PiotrPokornowski/ELA2/README.md

# Projekt na zaliczenie ELA2



W ramach projektu wykonane zostały projekty 4 linii zasilających z wykorzystaniem przetowornic impulsowych i stabilizatorów napięcia.
Symulacje układów zostały przeprowadzone z wykorzystaniem rzeczywistych modeli elementów w LTSpice.
