PiotrPokornowski/ELA2/Projekt/docs/BOM.xlsx

Sheet: Digital
Element | Kod producenta | wartość
C1 | GRM155R61C105KA12 | 1u
C2 | GRM155R61C103KA01 | 10n
C3 | GRM155R61C104KA88 | 0.1u
C4 | 865080543009 | 47u
C5 | GRM1555C1H4R7BA01 | 47p
C6 | GRM188R61C106MA73 | 10u
C7 | GRT31MR61C155KE01 | 1.5u
C8 | GRT31MR61C155KE01 | 1.5u
C9 | GRT31MR61C155KE01 | 1.5u
C10 | 865080543009 | 47u
L1 | 7447706033 | 3.3u
Przetwornica | LT8640

Sheet: Analog 1
Element | Kod producenta | wartość
C1 | GRT31MR61C155KE01 | 1.5u
C2 | GRT155R61A475ME13 | 4.7u
Stabilizator | LT3012

Sheet: Analog 2
Element | Kod producenta | wartość
C1 | GRM155R61C103KA01 | 10n
C2 | GRT31MR61C155KE01 | 1.5u
C3 | GRM155R61C105KA12 | 1u
C4 | GRT1555C1E681JA02 | 680p
C5 | GRM1555C1E4R7CA01 | 4.7p
C6 | GRM188R61C106MA73 | 10u
C7 | GRM188R61C106MA73 | 10u
C8 | GRM188R61C106MA73 | 10u
C9 | GRM188R61C106MA73 | 10u
C10 | GRM188R61C106MA73 | 10u
C11 | GRM188R61C106MA73 | 10u
C12 | GRM188R61C106MA73 | 10u
L1 | 78404064047 | 4.7u
L2 | 78404064047 | 4.7u
L3 | 7447706033 | 3.3u
D1 | DFLS260
Przetwornica | LT8362

Sheet: Analog 3
Element | Kod producenta | wartość
C1 | GRM155R61C103KA01 | 10n
C2 | GRT31MR61C155KE01 | 1.5u
C3 | GRM155R61C105KA12 | 1u
C4 | GRT1555C1E681JA02 | 680p
C5 | GRM1555C1E4R7CA01 | 4.7p
C6 | GRM188R61C106MA73 | 10u
C7 | GRM188R61C106MA73 | 10u
C8 | GRM188R61C106MA73 | 10u
C9 | GRM188R61C106MA73 | 10u
C10 | GRM188R61C106MA73 | 10u
C11 | GRM188R61C106MA73 | 10u
C12 | GRM188R61C106MA73 | 10u
L1 | 78404064047 | 4.7u
L2 | 78404064047 | 4.7u
L3 | 7447706033 | 3.3u
D1 | DFLS260
Przetwornica | LT8362
