PiotrPokornowski/ELA2/Projekt/LTSpice/Analog_2/Analog_2.asc

C1: cap; 10n
C2: cap; 1.5µ; Rser=6m Lser=0.3n
C3: cap; 1µ
C4: cap; 680p
C5: cap; 4.7p; Rser=2m Lser=0.2n
C6: cap; 6.25µ; Rser=2.5m Lser=0.3n
C7: cap; 6.88µ; Rser=2.5m Lser=0.3n
C8: cap; 6.25µ; Rser=2.5m Lser=0.3n
C9: cap; 6.25µ; Rser=2.5m Lser=0.3n
C10: cap; 6.25µ; Rser=2.5m Lser=0.3n
C11: cap; 6.25µ; Rser=2.5m Lser=0.3n
C12: cap; 6.88µ; Rser=2.5m Lser=0.3n
D1: diode; DI_DFLS260
I1: current; {Iwy}; load
L1: ind; flux={4.7u*5.5A}*tanh(x/{5.5A}); Rser=28m
L2: ind; flux={4.7u*5.5A}*tanh(x/{5.5A}); Rser=28m
L3: ind; flux={3.3u*13.5A}*tanh(x/{13.5A}); Rser=0.0075
R1: res; 20k
R2: res; 36.5k
R3: res; 1Meg
R4: res; 154k
U1: LT8362
V1: voltage; 10; Rser=100m
Named nets: 0, IN, OUT
.tran 5m startup
.meas Pin AVG -V(IN)*I(V1) FROM 4m
.meas Pout AVG V(OUT)*I(I1) FROM 4m
.meas Eff param (Pout/Pin)*100 FROM 4m
.meas Vout_avg AVG V(OUT) FROM 4m
.meas Vout_pp PP V(OUT)*1000 FROM 4m
.meas Vin_pp PP V(IN)*1000 FROM 4m
.MODEL DI_DFLS260 D  ( IS=721.4n RS=80.00m BV=60.00 IBV=10.00
+ CJO=320.8p M=450.7m N=1.029 TT=10.00n EG=480.0m VJ=292.4m )
10u
10u
10u
10u
4.7p
.step param Iwy 0 0.1 0.01
