PiotrPokornowski/ELA2/Projekt/LTSpice/Analog_1/Analog_1.asc

C1: cap; 1.03µ; Rser=6m Lser=0.6n
C2: cap; 3.53µ; Rser=9m Lser=.2n
I1: current; {Iwy}; load
R1: res; 750k
R2: res; 249k
U1: LT3012
V1: voltage; 10; Rser=100m
Named nets: 0, OUT, IN
.tran 8m startup
.meas Pin AVG -V(IN)*I(V1) FROM 7m
.meas Pout AVG V(OUT)*I(I1) FROM 7m
.meas Eff param (Pout/Pin)*100 FROM 7m
.meas Vout_avg AVG V(OUT) FROM 7m
.meas Vout_pp PP V(OUT)*1000 FROM 7m
.meas Vin_pp PP V(IN)*1000 FROM 7m
1.5u
4.7u
.step param Iwy 0 .25 .025
