PiotrPokornowski/ELA2/Projekt/LTSpice/Digital/digital.asc

C1: cap; 1µ; Rser=5m Lser=0.2n
C2: cap; 10n; Rser=250m Lser=0.3n
C3: cap; .1µ; Rser=30m Lser=0.2n
C4: polcap; 43.6µ; Rser=350m Lser=3n
C5: cap; 4.7p; Rser=2m Lser=0.2n
C6: cap; 6.88µ; Rser=2.5m Lser=0.3n
C7: cap; 1.03µ; Rser=6m Lser=0.6n
C8: cap; 1.03µ; Rser=6m Lser=0.6n
C9: cap; 1.27µ; Rser=5m Lser=0.6n
C10: polcap; 43.6µ; Rser=350m Lser=3n
I1: current; {Iwy}
L1: ind; flux={3.3u*13.5A}*tanh(x/{13.5A}); Rser=0.0075
R1: res; 41.2k
R2: res; 1Meg
R3: res; 243k
U1: LT8640
V1: voltage; 10; Rser=100m
Named nets: 0, OUT, IN
.tran 8m startup
.meas Pin AVG -V(IN)*I(V1) FROM 7m
.meas Pout AVG V(OUT)*I(I1) FROM 7m
.meas Eff param (Pout/Pin)*100 FROM 7m
.meas Vout_avg AVG V(OUT) FROM 7m
.meas Vout_pp PP V(OUT)*1000 FROM 7m
.meas Vin_pp PP V(IN)*1000 FROM 7m
10u
47u
1.5u
1.5u
1.5u
.step param Iwy 0 5 0.5
