PiotrPokornowski/ELA2/(commit log)

2024-05-30 Updated project structure
    [segment_1.csv, segment_2.csv]
2024-05-30 Updated actions script for externalization
    [segment_1.csv, segment_2.csv]
2024-05-30 Updated report
    [segment_1.csv, segment_2.csv]
2024-06-02 Added BOM
    [BOM.xlsx]
